Simon-Ed/Motorized-nerf-gun/259450840_3096430580610574_3366839771590288742_n.jpg

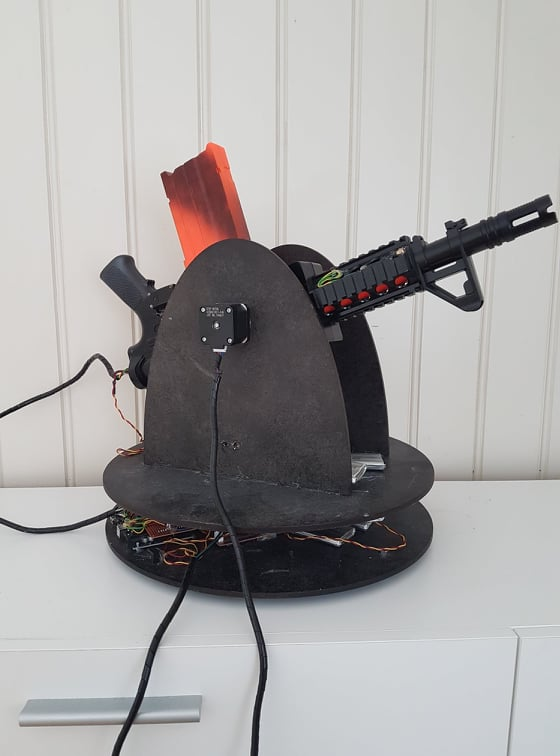
259450840_3096430580610574_3366839771590288742_n.jpg
