Simon-Ed/Motorized-nerf-gun/272933340_245507190971829_6287928357800410121_n.jpg

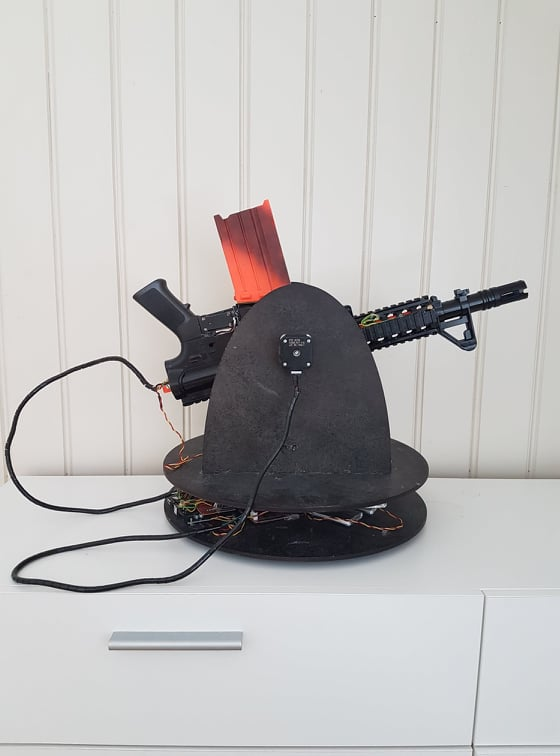
272933340_245507190971829_6287928357800410121_n.jpg
