Simon-Ed/Motorized-nerf-gun/272997021_366375421584420_5356362479852252374_n.jpg

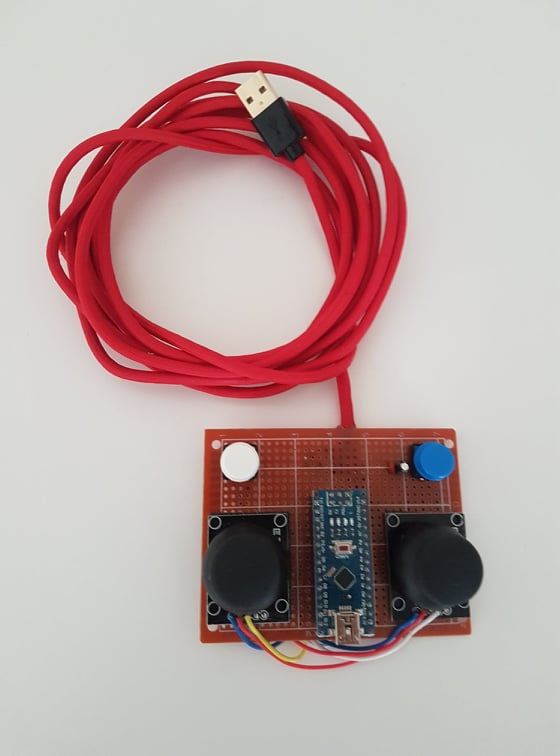
272997021_366375421584420_5356362479852252374_n.jpg
