Simon-Ed/Motorized-nerf-gun/273000607_3113551915587373_2748835335022725189_n.jpg

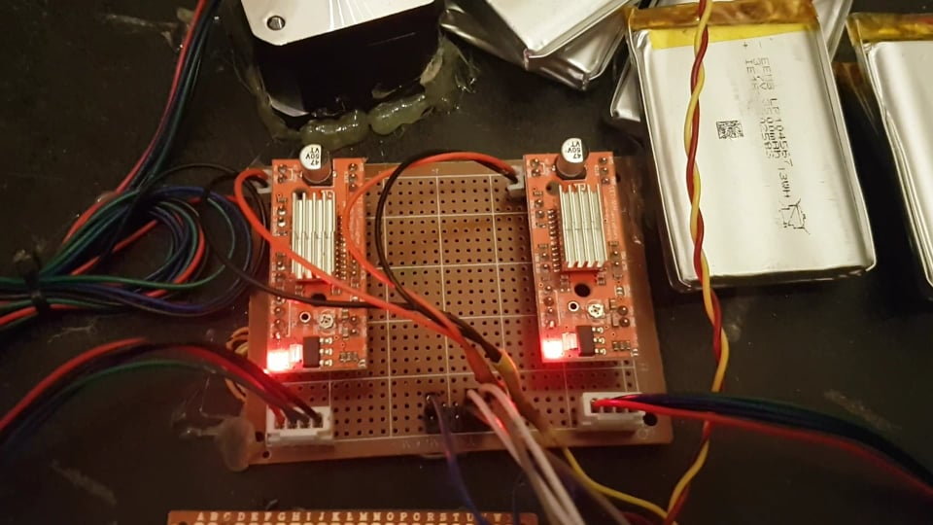
273000607_3113551915587373_2748835335022725189_n.jpg
