Simon-Ed/Motorized-nerf-gun/273087150_1009783609893554_7604053367437499196_n.jpg

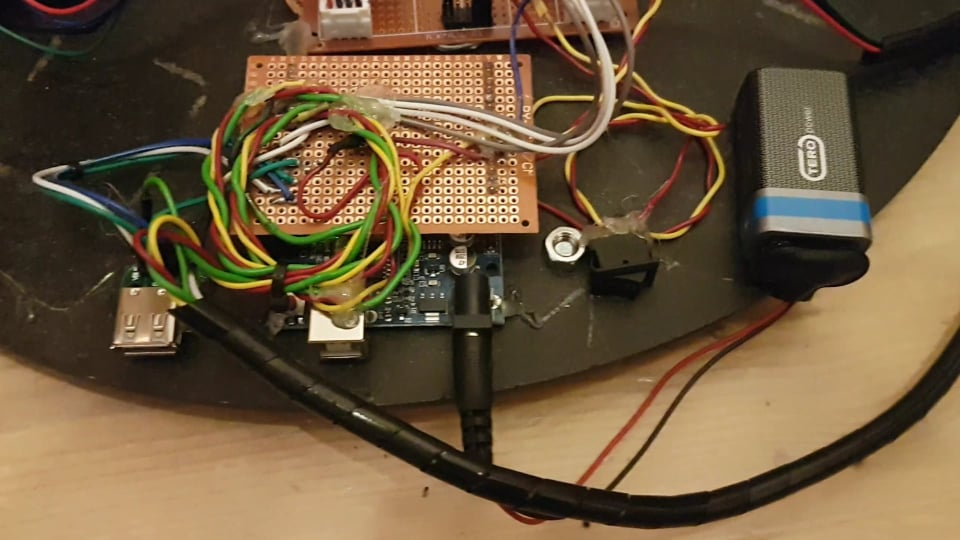
273087150_1009783609893554_7604053367437499196_n.jpg
